Questx0314/pressure-monitor-stm32F405/PCB/panel_front.stp

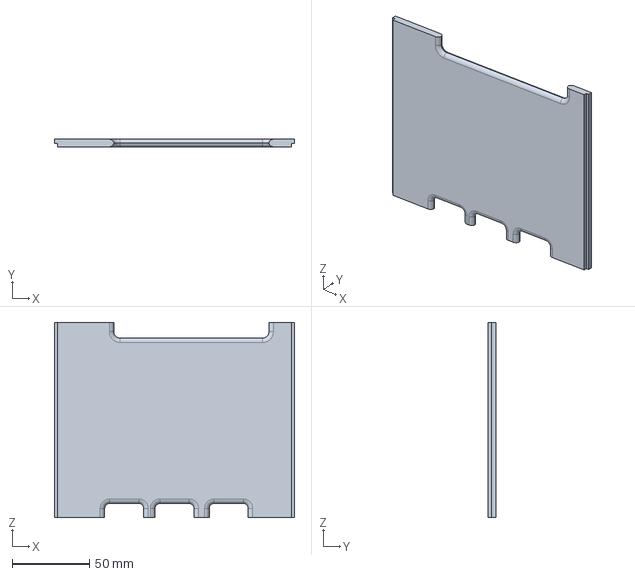
[picture p1: CAD file, 2025-04-30]
PCB/panel_front.stp
155.0 x 4.90 x 126.0 mm
