Questx0314/pressure-monitor-stm32F405/PCB/o-cover.stp

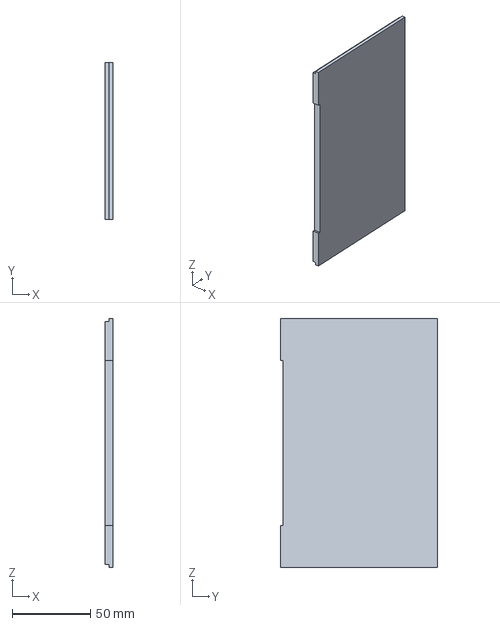
[picture p2: CAD file, 2025-04-30]
PCB/o-cover.stp
5.00 x 100.0 x 159.0 mm
