Questx0314/pressure-monitor-stm32F405/PCB/panel_back.stp

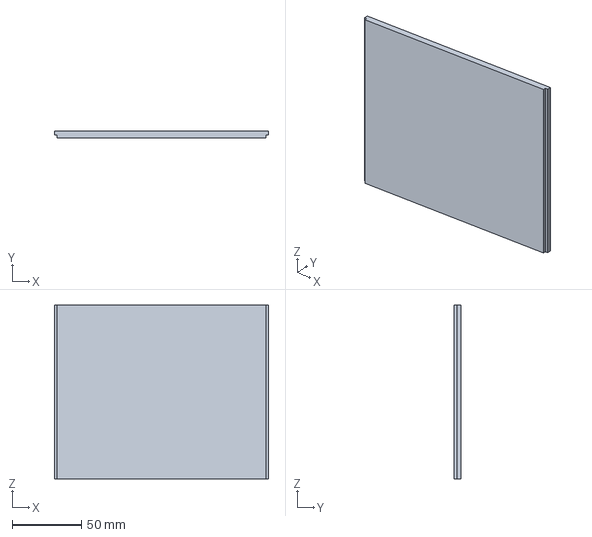
[picture p3: CAD file, 2025-04-30]
PCB/panel_back.stp
155.0 x 4.90 x 126.0 mm
