Questx0314/pressure-monitor-stm32F405/PCB/o-box.stp

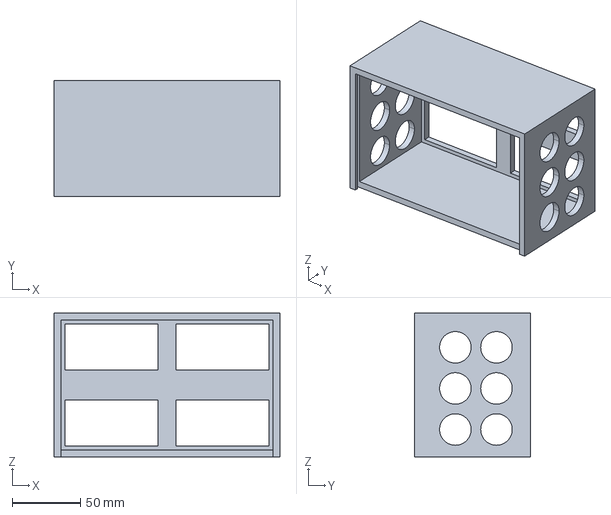
[picture p4: CAD file, 2025-04-30]
PCB/o-box.stp
165.0 x 85.0 x 105.0 mm
