Questx0314/pressure-monitor-stm32F405/PCB/box.stp

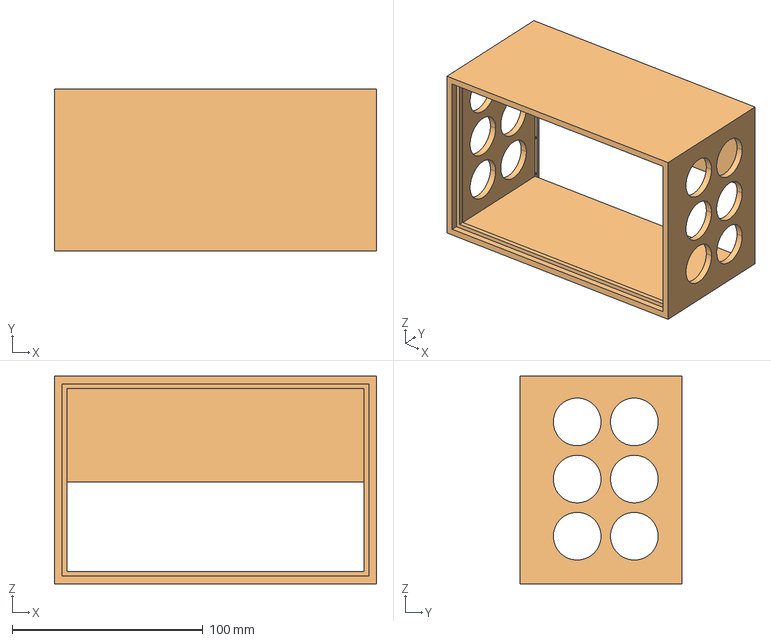
[picture p5: CAD file, 2025-04-30]
PCB/box.stp
169.0 x 85.0 x 109.0 mm
