Questx0314/pressure-monitor-stm32F405/PCB/test.stp

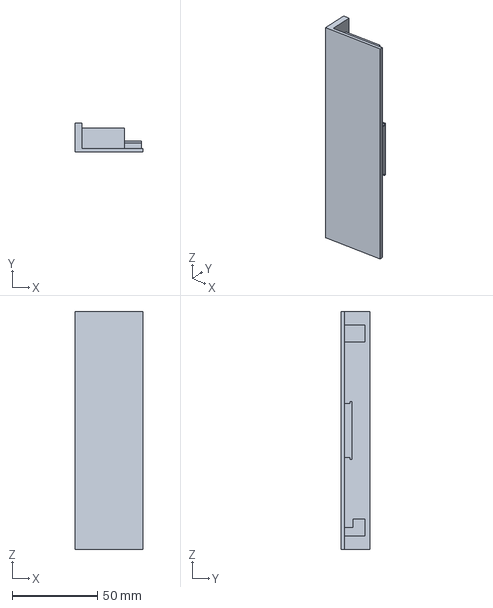
[picture p6: CAD file, 2025-04-30]
PCB/test.stp
40.0 x 17.0 x 140.0 mm
