Questx0314/pressure-monitor-stm32F405/PCB/pannel.stp

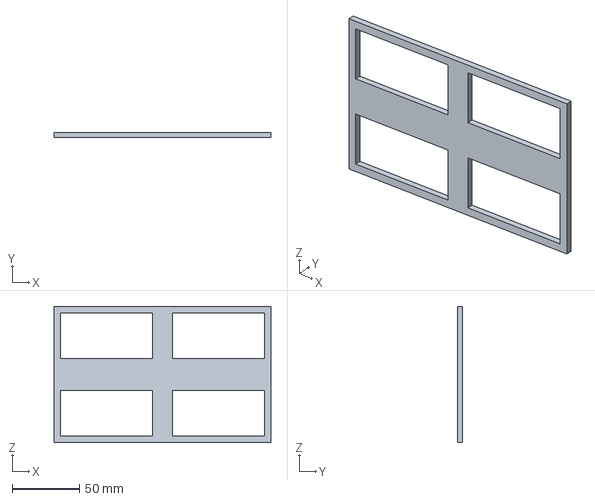
[picture p7: CAD file, 2025-04-30]
PCB/pannel.stp
160.8 x 4.00 x 100.8 mm
