Questx0314/pressure-monitor-stm32F405/PCB/cover.stp

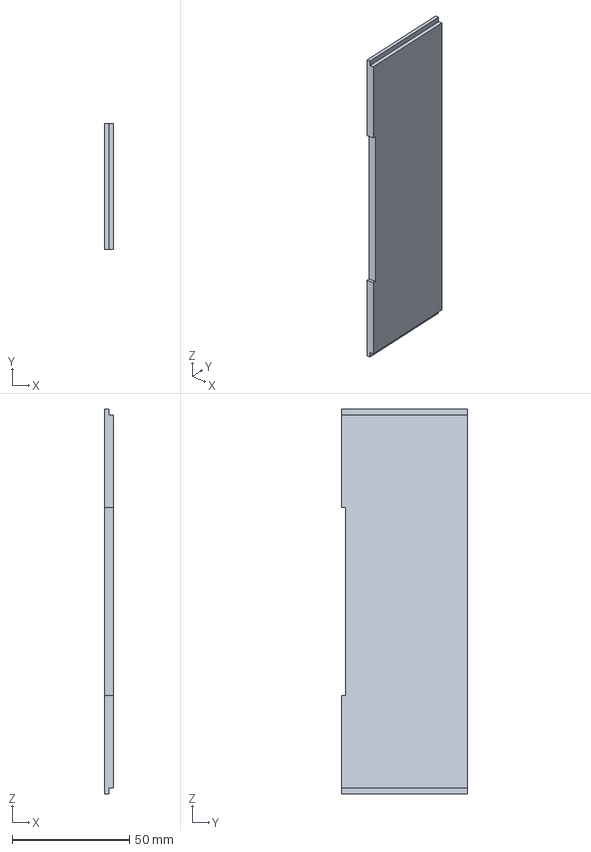
[picture p8: CAD file, 2025-04-30]
PCB/cover.stp
3.80 x 53.5 x 164.0 mm
