Questx0314/pressure-monitor-stm32F405/PCB/camera_install.stp

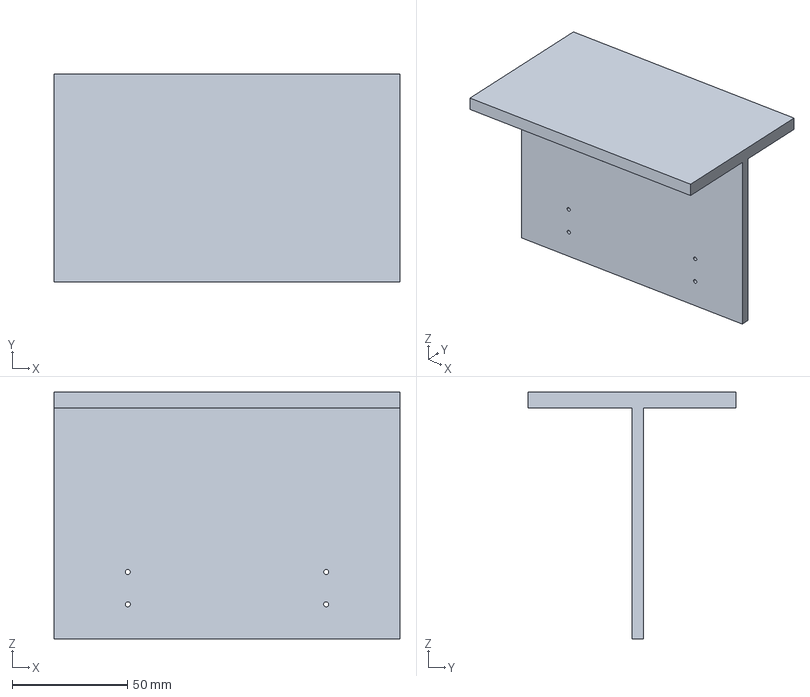
[picture p9: CAD file, 2025-04-30]
PCB/camera_install.stp
150.0 x 90.0 x 107.0 mm
