Questx0314/pressure-monitor-stm32F405/(list of files, cad)

Other CAD files:
PCB/panel_back.stl
PCB/panel_front.stl
