Questx0314/pressure-monitor-stm32F405/(list of files, drawings)

Other design files:
PCB/压力传感器monitor.eprj
