Questx0314/pressure-monitor-stm32F405/STM/F405/Src/main.c

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
/* Includes ------------------------------------------------------------------*/
#include "main.h"
#include "adc.h"
#include "dma.h"
#include "usb_device.h"
#include "gpio.h"

/* USER CODE BEGIN Includes */
// #include "adjuster.h"
#include "usbd_cdc_if.h"
/* USER CODE END Includes */

/* USER CODE BEGIN PM */

#define ADC_CHANNELS 5

#define MAX_TX_LEN 128
uint16_t adc_buffer[ADC_CHANNELS] = {0};
#define ADC_NOISE_THRESHOLD 100
/* USER CODE END PM */


void SystemClock_Config(void);
/* USER CODE BEGIN PFP */
void SendResponse(char* response)
{
  uint8_t buffer[MAX_TX_LEN];
  uint16_t len = snprintf((char*)buffer, sizeof(buffer), "%s", response);
  CDC_Transmit_FS(buffer, len);
}
void ProcessReceivedData(uint8_t* data, uint32_t len)
{
    if (strstr((char*)data, "FS connect") == (char*)data)
    {
        char msg[MAX_TX_LEN];
        memset(msg, 0, sizeof(msg));
        snprintf(msg,sizeof(msg),"connect success2222");
        SendResponse(msg);
    }
    else if (strstr((char*)data, "data request") == (char*)data)
    {
      char usb_tx_buffer[MAX_TX_LEN];
      memset(usb_tx_buffer, 0, sizeof(usb_tx_buffer));
      // 添加噪声过滤
      snprintf(usb_tx_buffer, sizeof(usb_tx_buffer),
      "CH0: %d | CH1: %d | CH2: %d | CH3: %d | CH4: %d\r\n",
      (adc_buffer[0] < ADC_NOISE_THRESHOLD) ? 0 : adc_buffer[0],
      (adc_buffer[1] < ADC_NOISE_THRESHOLD) ? 0 : adc_buffer[1],
      (adc_buffer[2] < ADC_NOISE_THRESHOLD) ? 0 : adc_buffer[2],
      (adc_buffer[3] < ADC_NOISE_THRESHOLD) ? 0 : adc_buffer[3],
      (adc_buffer[4] < ADC_NOISE_THRESHOLD) ? 0 : adc_buffer[4]
			);
      SendResponse(usb_tx_buffer);
    }
    else
    {
        SendResponse("Unknown command");  // 回传未识别的命令
    }
}
void USB_Init(void)
{
  GPIO_InitTypeDef GPIO_InitStruct = {0};

  /* GPIO Ports Clock Enable */
  __HAL_RCC_GPIOA_CLK_ENABLE();

  /*Configure GPIO pin Output Level */
  HAL_GPIO_WritePin(GPIOA, GPIO_PIN_11|GPIO_PIN_12, GPIO_PIN_RESET);

  /*Configure GPIO pin : PA8 */
  GPIO_InitStruct.Pin = GPIO_PIN_11|GPIO_PIN_12;
  GPIO_InitStruct.Mode = GPIO_MODE_OUTPUT_OD;
  GPIO_InitStruct.Pull = GPIO_PULLDOWN;
  GPIO_InitStruct.Speed = GPIO_SPEED_FREQ_LOW;
  HAL_GPIO_Init(GPIOA, &GPIO_InitStruct);

  HAL_Delay(50);
}
//void HAL_ADC_ConvCpltCallback(ADC_HandleTypeDef* hadc)
//{

//  // {
//  //   // 处理接收到的数据
//  //   ProcessReceivedData((uint8_t*)adc_buffer, sizeof(adc_buffer));
//  // }
//  if (HAL_ADC_Start_DMA(&hadc1, (uint32_t*)adc_buffer, ADC_CHANNELS ) != HAL_OK)
//  {
//    // Handle error
//    Error_Handler();
//  }
//}
// 启动ADC DMA转换
void ADC_Start_DMA(void) {
  // Ensure ADC is properly configured before starting DMA
  if (HAL_ADC_Start_DMA(&hadc1, (uint32_t*)adc_buffer, ADC_CHANNELS ) != HAL_OK)
  {
    // Handle error
    Error_Handler();
  }
}

/* USER CODE END PFP */

/**
  * @brief  The application entry point.
  * @retval int
  */
int main(void)
{
  /* MCU Configuration--------------------------------------------------------*/

  /* Reset of all peripherals, Initializes the Flash interface and the Systick. */
  HAL_Init();

  /* USER CODE BEGIN Init */
  USB_Init();
  /* USER CODE END Init */

  /* Configure the system clock */
  SystemClock_Config();

  /* Initialize all configured peripherals */
  MX_GPIO_Init();
  MX_DMA_Init();
  MX_USB_DEVICE_Init();
  MX_ADC1_Init();
  /* USER CODE BEGIN 2 */

  // {
  //   Error_Handler();
  // }
  ADC_Start_DMA();
  /* USER CODE END 2 */

  /* Infinite loop */
  /* USER CODE BEGIN WHILE */
  while (1)
  {
    /* USER CODE END WHILE */

    /* USER CODE BEGIN 3 */
  }
  /* USER CODE END 3 */
}

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
