Questx0314/pressure-monitor-stm32F405/(commit log)

2025-03-22 V0.0
    Origin
    [压力传感器monitor.eprj]
2025-04-03 V0.1
    上位机初版
    [压力传感器monitor.eprj]
2025-04-30 V0.5
    软件版本计时功能暂时完善。需要补充：
    1.支持外部物理按钮控制
    2.重新设计硬件电路保证抗干扰和准确性
    3.增加调零按钮
    [box.stp, camera_install.stp, cover.stp, o-box.stp, o-cover.stp, panel_back.stl, panel_back.stp, panel_front.stl]
