Questx0314/pressure-monitor-stm32F405/(notices)

Notices in the files:
STM/F405/Src/main.c:
Copyright (c) 2024 STMicroelectronics.
All rights reserved.
This software is licensed under terms that can be found in the LICENSE file
